maf70/Woodie/infos/prototype.jpg

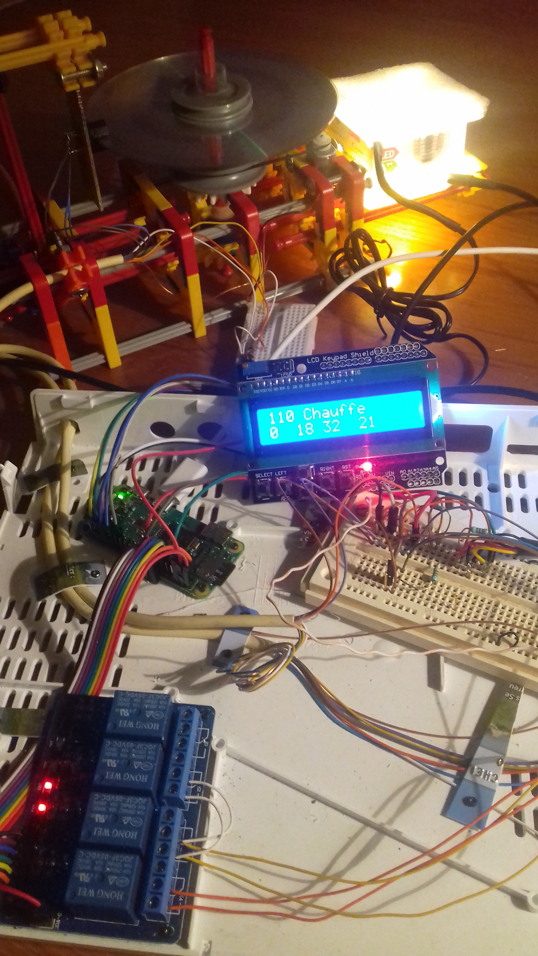
infos/prototype.jpg
