maf70/Woodie/(threads)

Thread 1 (2018-03-25):

task crash if thermo file not found

maf70, 2018-03-25:
Exception in thread Thread-4:
Traceback (most recent call last):
  File "/usr/lib/python2.7/threading.py", line 801, in __bootstrap_inner
    self.run()
  File "/home/pi/Woodie/hw.py", line 72, in run
    f=open("/sys/bus/w1/devices/"+self.device+"/w1_slave","r")
IOError: [Errno 2] No such file or directory: '/sys/bus/w1/devices/28-0417c1418bff/w1_slave'

Exception in thread Thread-5:
Traceback (most recent call last):
  File "/usr/lib/python2.7/threading.py", line 801, in __bootstrap_inner
    self.run()
  File "/home/pi/Woodie/hw.py", line 72, in run
    f=open("/sys/bus/w1/devices/"+self.device+"/w1_slave","r")
IOError: [Errno 2] No such file or directory: '/sys/bus/w1/devices/28-0517c1392fff/w1_slave'

maf70, 2018-03-25:
Set exception handler to IOError

Closed 2018-03-25.

Thread 3 (2018-04-04):

Interrupt callback not called

maf70, 2018-04-04:
Sometimes, optical sensors don't work at startup, callback are not called at all.

Minimal code to reproduce the problem, running many times :
for i in `seq 1 1 100`; do echo -n  "$i ";python test/test_capt.py; done

Seems better (worked 400 times with only one error => 0.125%) when removing then setting again the gpio config :

        # Removing then adding again interrupt config seems to fix #3
        GPIO.remove_event_detect(26)
        time.sleep(0.002)
        GPIO.add_event_detect(26, GPIO.RISING, callback=eCallback, bouncetime=10)
        time.sleep(0.002)

Closed 2018-05-11.

Thread 4 (2018-05-12):

Too much interrupts, system is disturbed

maf70, 2018-05-12:
Sometimes, when motor stops with a hole near an optical sensor, then sensor trigs a lot of interrupts.

=> Need to disable interrupt when motor is stopped.
