maf70/Woodie/reglages.py

#!/usr/bin/python

import json


################################
################################


################################
#  "Constantes communes"
################################

ON=0
OFF=1
PAUSE=2

################################
#  Cablage. Non modifiable.
################################

# Configuration des gpio pour la commande des relais
# !! Numerotation Broadcom !!
# Board equivalent : 12 11 13 15
r1 = 25
r2 = 24
r3 = 23
r4 = 18

# Software SPI configuration.
# !! Numerotation Broadcom !!
SpiCLK = 10     # r8
SpiCS  =  9     # r7
SpiDO  = 11     # r6

# Configuration des gpio pour les compteurs
# !! Numerotation Broadcom !!
# Board equivalent : 37 18
b1 = 20
b2 = 21

# Configuration des gpio pour les detecteurs secteur
# !! Numerotation Broadcom !!
# Board equivalent : 21 19
d1 = 16
d2 = 12

# Configuration gpio led
# !! Numerotation Broadcom !!
l1 = 26

# Configuration gpio poussoir
# !! Numerotation Broadcom !!
p5 = 17
p4 = 27
p3 = 22
p2 = 8
p1 = 7

# Configuration des gpio  du lcd
# !! Numerotation Broadcom !!
#lcd_rs        = 20
#lcd_en        = 16
#lcd_d4        = 19
#lcd_d5        = 13
#lcd_d6        = 12
#lcd_d7        = 5
#lcd_backlight = 21

# Bus i2c & addresses
i2cBusNum = 1
i2cNano   = 0x08
i2cLCD    = 0x3f
