maf70/Woodie/(commit log)

2018-03-15 Add log module + samples
2018-03-15 Add log samples
2018-03-19 Controle rotation de la vis avec plusieur capteurs
2018-03-19 Chargement des reglages depuis un fichier
2018-03-21 ajout du serveur flask + template html/js de graph
2018-04-05 add reset button on conf form
2018-05-01 Add power sensor. Pause controller instead of stop
2018-05-01 Get type K thermocouple value via i2c from nano
2018-05-05 Add LCD i2c library from DenisFromHR
2018-05-05 Use LCD on i2c bus. Add i2c manager task
2018-05-10 Dallas bus manager : avoid 1-wire acces conflicts
    [hw.py]
2018-05-10 Manage all motor blocking cases
2018-05-11 Change piZero GPIO for pcb routing
2018-05-14 Add on/off function in compteur class (doesn't work : seg fault ...)
    [controleurs.py, hw.py]
2018-05-14 Fix #4 : deactivate compteur C1 (home made sensor with discrete component)
2018-05-24 Fix motor blocking
2018-05-24 Add led class
2018-05-24 Add error led
2018-05-24 Add push button to restart after motor blocking
2018-09-03 Activate second motor sensor
2018-09-03 Stop logging if no power
2018-09-04 Sonde K : use MAX31855 (SW SPI) instead of nano+LM358
2018-09-06 Manage vMin specific value and blocking counter for each optical sensor.
2018-09-06 Reset blocking counter when push button. Fix affiche() function in Entree class
    [hw.py]
2018-09-07 Check sonde K value and stop if temperature under min value
2018-09-09 Log errors and event in .err file. Add it to html pages
    [traceur.py]
2018-09-10 Log motor inversions
2018-09-10 Add push button to shut down whole system
2018-10-07 Add html button to restart Woodie
2018-10-11 Add button to activate wifi AP
2018-10-14 Replace woodie.py by chaudiere.py
    [woodie.py]
2018-10-14 Add empty line in log file, to avoid some inconsistencies
    [traceur.py]
2018-10-15 Define tracked objects labels in traceur instead at object creation
2018-10-16 Check log consistency with traceur infos
2019-08-15 Create i2c file mapping
2019-08-15 Refine Class traceur
2019-08-18 traceur class : ensure file write every two hours
